BradPatras/pi-frame/images/donuts1.jpg

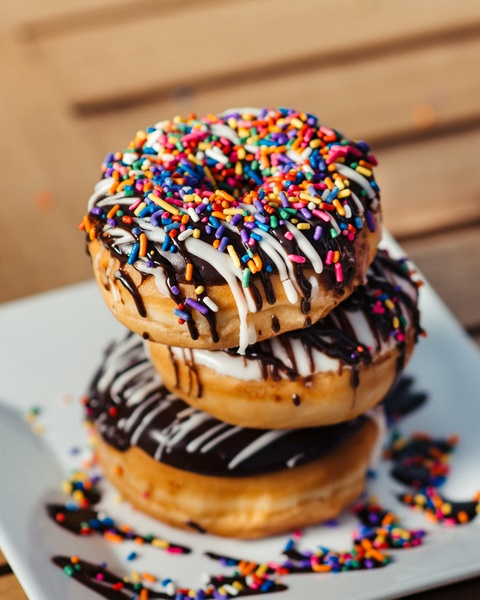
images/donuts1.jpg
