BradPatras/pi-frame/images/coffee1.jpg

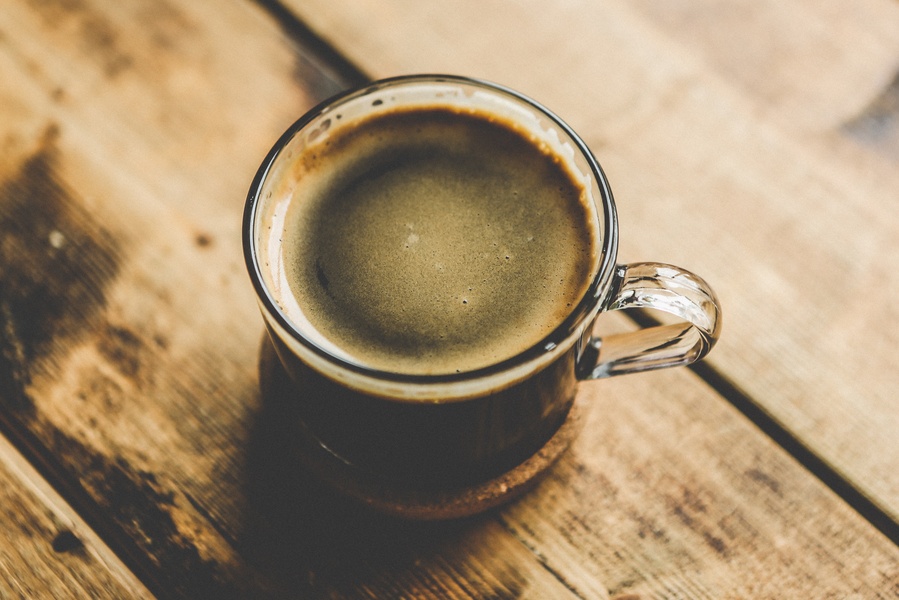
images/coffee1.jpg
