BradPatras/pi-frame/design/schematic.png

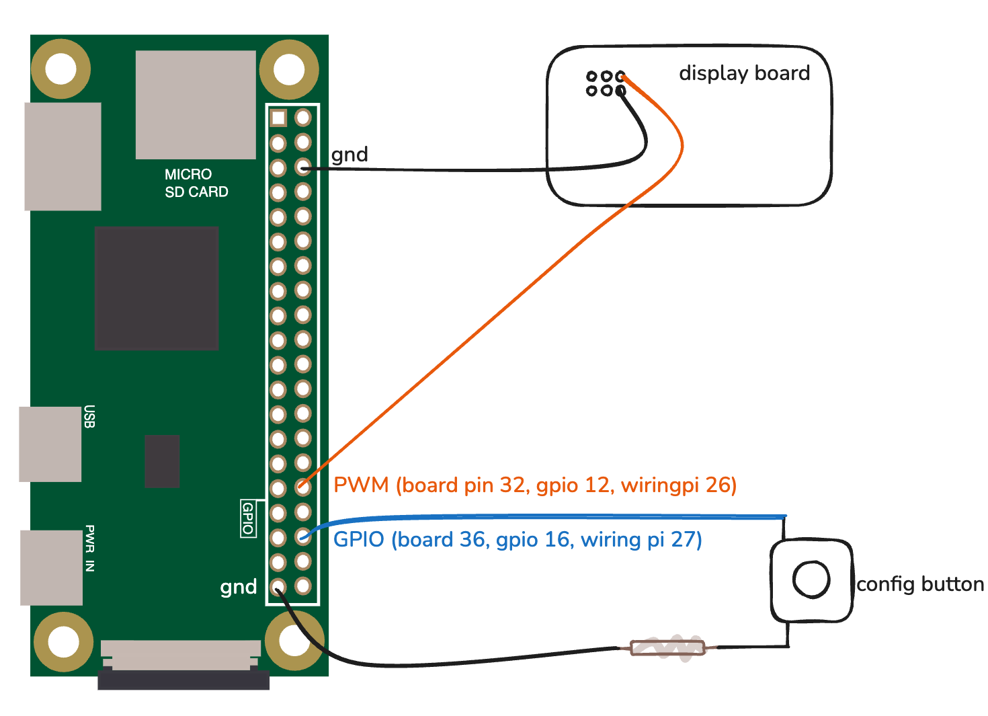
design/schematic.png
