BradPatras/pi-frame/enclosure-models/schematic.png

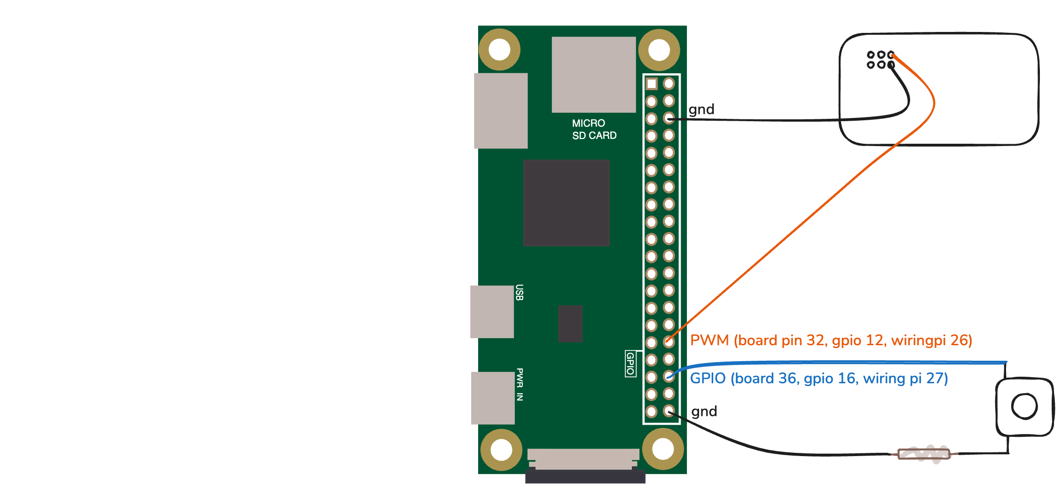
enclosure-models/schematic.png
