BradPatras/pi-frame/static/images/coffee2.jpg

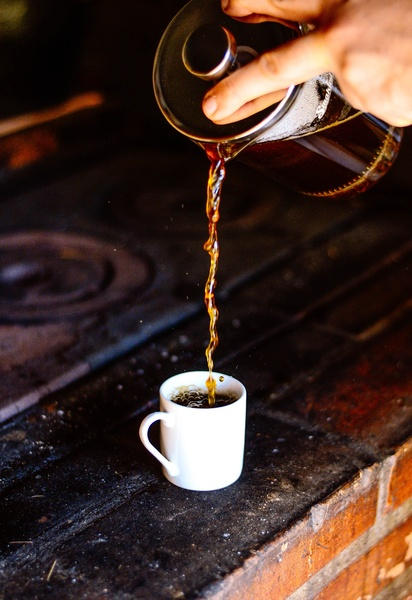
static/images/coffee2.jpg
