BradPatras/pi-frame/static/images/donuts2.jpg

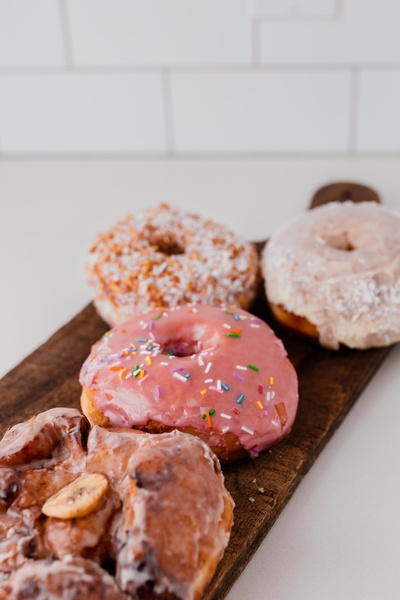
static/images/donuts2.jpg
