BradPatras/pi-frame/design/back-panel-3.stl

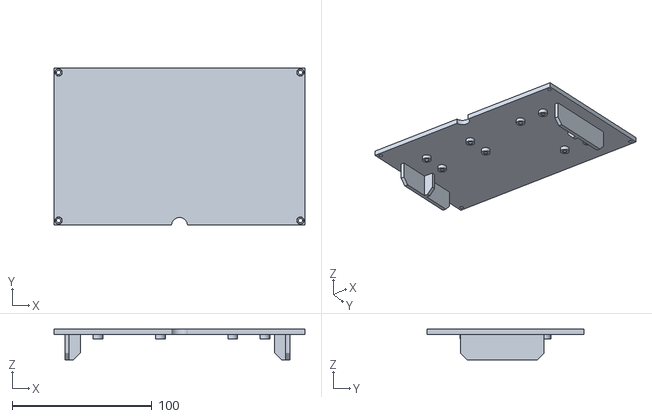
[picture p7: CAD file, 2026-06-07]
design/back-panel-3.stl
179.6 x 112.6 x 22.1
