BradPatras/pi-frame/enclosure-models/front-panel-2.stl

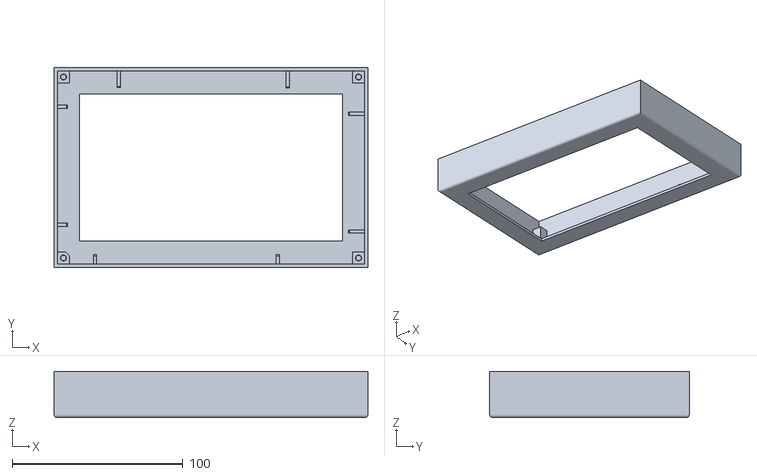
[picture p8: CAD file, 2026-05-16]
enclosure-models/front-panel-2.stl
184.0 x 117.0 x 27.0
