BradPatras/pi-frame/enclosure-models/back-panel-2.stl

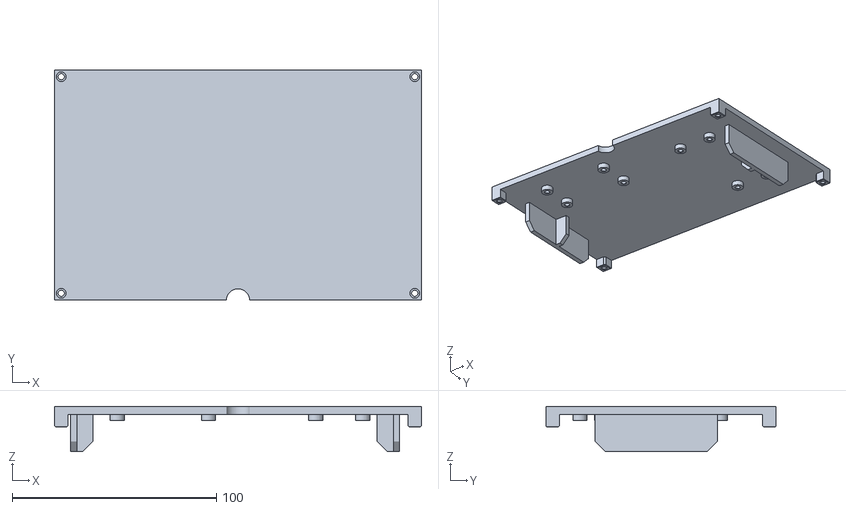
[picture p9: CAD file, 2026-05-16]
enclosure-models/back-panel-2.stl
179.6 x 112.6 x 22.1
