BradPatras/pi-frame/(list of files, cad)

Other CAD files:
design/front-panel-3.stl
