BradPatras/pi-frame/(commit log)

2026-01-18 switched to vite for frontend react app
2026-01-19 styled button and tweaked color temp input
2026-01-22 merged the pi frame python scripts into a single file and took a first pass at implementing the button-controlled modes
2026-02-03 added the server startup actions to config setup function and added the color temperature adjustment to the photo render func
2026-02-09 removed npm build step from frame script. The pi shouldn't need node or npm installed at all
2026-02-09 added current image list to config page
2026-02-13 Switch from pigpio to gpiozero since pigpio is no longer maintained
2026-03-29 prepping for deployment to frame. - added frame build task to justfile - updated install script to no longer internally sudo - updated frame py script to use the networking py functions
2026-04-01 tweaks while testing on the real hardware. Got the main functionality working 🥹
2026-04-02 updated start script to use startx when running the frame program in order to facilitate running without desktop env
2026-04-12 updated frame config screen to have wifi qr code and interface webpage qr code. Also cleaned up hotspot initializtion a bit and added server shutdown when frame goes to viewer mode.
2026-04-12 tweaks to config screen to fit frame better, added wait to start hotspot script so that it works more reliably
2026-04-12 added a loading spinner to the frame config frontend
2026-05-16 add resampling method lanczos to downsizing step to get best quality and added else case to keep small images untouched.
2026-05-30 starting to add night mode/dimming functionality. Added basic wiring drawing
2026-06-02 updated the frontend to feed the client's date/time to the frame upon screen load. Fixed the systemd service so now it works again!
2026-06-07 chamfer back panel holes for screw heads
2026-06-07 reorg into frame-core, frame-config-frontend, frame-config-backend
2026-06-08 swapped to logging to file instead of just printing, testing color temp func (doesn't work, might remove)
2026-06-28 fixed schematic
2026-10-15 Polished up readme and moved current readme contents to the dev-docs.md file
